PaulZC/F9P_RAWX_Logger/img/RingBuffer.JPG

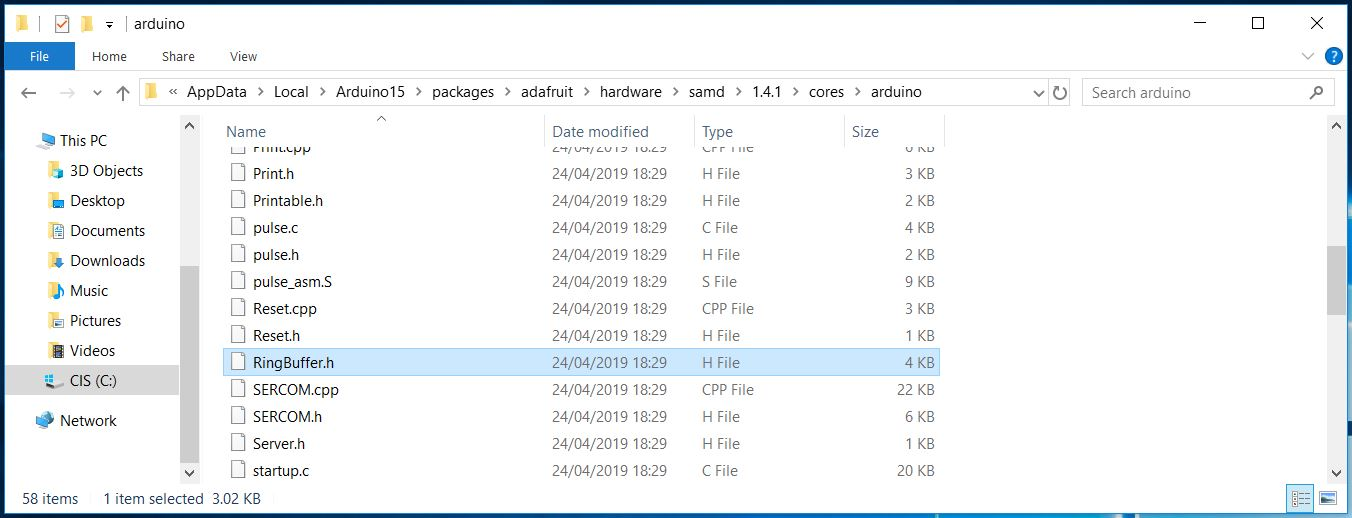
img/RingBuffer.JPG
