PaulZC/F9P_RAWX_Logger/img/VariantCPP.JPG

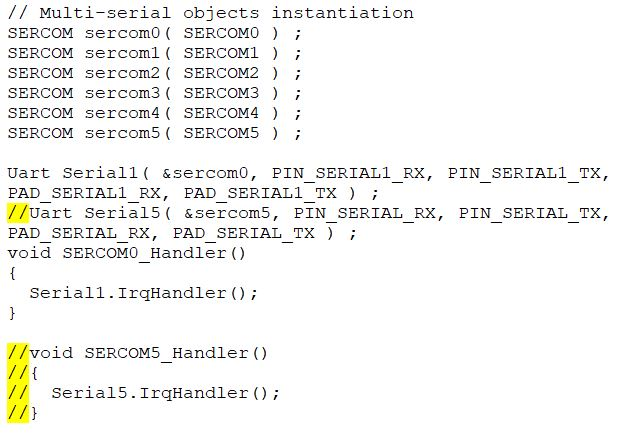
img/VariantCPP.JPG
