PaulZC/F9P_RAWX_Logger/img/VariantH.JPG

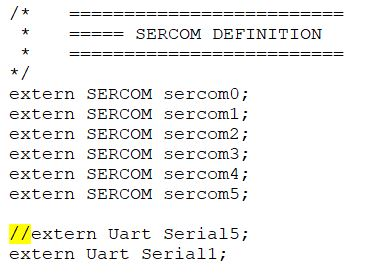
img/VariantH.JPG
