PaulZC/F9P_RAWX_Logger/(threads)

Thread 1 (2019-09-17):

10hz logging

Stefal, 2019-09-17:
Hi!

Thank you for your sketch and the extensive documentation, it' a lot of work.

I've made some modifications on this [branch](https://github.com/Stefal/F9P_RAWX_Logger/tree/datetime_i2c):
- Use i2c to get date and time from the F9P
- Rewrite of the alarm calculation to support more than 60 minutes interval
- nmea output isn't needed anymore and I removed the GPS Adafruit dependencie
- Added a button to start a delayed stop

Do you want a pull request ?

My next goal is to log at [10Hz](https://github.com/Stefal/F9P_RAWX_Logger/tree/high_speed/Arduino) but I have some problems:
- some checksum errors
- Many errors reported when I convert the ubx file to rinex files.
- Sometimes the ringbuffer (24K) is full.

I don't know if my sketch is incorrect, or if I'm hardware limited on UART and if we should use I2c to get the data from the F9P.
Do you have an idea about this?

PaulZC, 2019-09-18:
Hi Stefal,
Apologies - the code in this repo isn't as up to date as it should be. You can find the latest version in the [ZED-F9P_FeatherWing_USB repo](https://github.com/PaulZC/ZED-F9P_FeatherWing_USB). The I2C logger code uses the new multiSetVal functions for the F9 in the SparkFun u-blox library. Please check if [this version](https://github.com/PaulZC/ZED-F9P_FeatherWing_USB/blob/master/Arduino/RAWX_Logger_F9P_I2C/RAWX_Logger_F9P_I2C.ino) meets your needs.
My plan is to update the code in this repo as soon as I have time. I'll close this issue once I've done that. (I'm away from home at the moment.)
Best wishes,
Paul

PaulZC, 2019-11-24:
Hi Stefal,
Thanks again for your comments.
I finally found time to update the RAWX_Logger_F9P_I2C code so it matches the code in the ZED-F9P_FeatherWing_USB repo.
I have also updated RAWX_Logger_F9P so it uses the SparkFun Ublox library and have removed the dependence on the Adafruit library.
I wouldn't recommend logging RAWX data to a single file for longer than 60 minutes. If you have a power glitch while logging, you could lose all your data. Joining the .ubx files together is easy to do so I'd recommend doing that if you can.
The delayed stop is a nice feature but I won't be adding it as I'd like to maintain compatibility with the [RAWX_Logger_Switches](https://github.com/PaulZC/RAWX_Logger_Switches).
I hope the I2C code fixes your 10Hz logging issues. Please let me know if it does.
All the best,
Paul

Stefal, 2020-09-18:
Hi, and thank you for the update!
I'm still stuck at 8Hz. It looks like an arduino sd card bandwidth limit.

Sorry for answering so late, I'm a little busy on other projects, perhaps this one could interesting you: [RTKBase](https://github.com/Stefal/rtkbase)

PaulZC, 2020-09-18:
Hi @Stefal ,
It may not be an SD card issue. It is probably because you have too many constellations enabled?
I have had RAWX running at 20Hz, but you can only do this using GPS only. If I have all constellations enabled, I2C starts to fail at about 5Hz. Sometimes you can go faster, but it depends how many SV's are in view and so how much RAWX data is being produced.
Good luck with your project! RTKBase looks nice! ;-)
Best wishes,
Paul

Closed 2019-11-24.

Thread 4 (2020-10-06):

SD Card Init Failed

uweboerst, 2020-10-06:
Hi Paul,
I followed your instructions to build a F9P_RAWX_Logger to the letter, but unfortunately I cannot get the adalogger to work properly. I always get the following error message in the serial plotter:

RAWX Logger F9P
Log GNSS RAWX data to SD Card
Green LED = Initial GNSS Fix
Red LED Flash = SD Write
Continuous Red indicates a problem or that logging has been stopped
Initializing GNSS...
Ublox GNSS found!
Rover mode selected
GNSS initialized!
Initializing SD card...
Panic!! SD Card Init Failed, or not present!
Waiting for reset...

I have built the logger twice (as I need a rover and a base station) and both have the same issue. I used different sd cards and formatted them properly but it didn't help.
Do you have any idea what could be the reason?
I would very much appreciate your support as my programing skills are very limited.

Uwe

PaulZC, 2020-10-07:
Hi Uwe ( @uweboerst ),

What size SD card are you using - and have they been formatted with FAT32? Larger SD cards are formatted with ExFAT and the SdFat library does not currently support those. There are some instructions in [paragraph 4 here](https://github.com/PaulZC/F9P_RAWX_Logger/blob/master/HARDWARE.md#adafruit-feather-m0-adalogger).

If you want to test the Adalogger and card, Adafruit have some [examples](https://learn.adafruit.com/adafruit-feather-m0-adalogger/using-the-sd-card) to help you do that.

Please let me know if you need more help!

Best wishes,

Paul

uweboerst, 2020-10-07:
Hi Paul,

thank you for your quick response.

I'm using a SDHC class 10 4GB SD card.

I tested the Adalogger and card with the examples provided by Arduino as suggested and they all work fine.

For example if I run CardInfo I get the following message:

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

But I cannot run any of the examples that come with Bill Greiman's SdFat.

If I run bench§ (see code at the bottom of this post) provided by Greiman I do receive the following message:

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

Is it possible that something is wrong with SdFat by Greiman? Do I have to change a pin or anything else?
Regards
Uwe

Code for bench§ by Bill Greiman:

`/*
 * This program is a simple binary write/read benchmark.
 */
#include <SPI.h>
#include "SdFat.h"
#include "sdios.h"
#include "FreeStack.h"

// Set USE_SDIO to zero for SPI card access.
#define USE_SDIO 0

// SD chip select pin
const uint8_t chipSelect = 4;

// Size of read/write.
const size_t BUF_SIZE = 512;

// File size in MB where MB = 1,000,000 bytes.
const uint32_t FILE_SIZE_MB = 5;

// Write pass count.
const uint8_t WRITE_COUNT = 2;

// Read pass count.
const uint8_t READ_COUNT = 2;
//==============================================================================
// End of configuration constants.
//------------------------------------------------------------------------------
// File size in bytes.
const uint32_t FILE_SIZE = 1000000UL*FILE_SIZE_MB;

uint8_t buf[BUF_SIZE];

// file system
#if USE_SDIO
// Traditional DMA version.
// SdFatSdio sd;
// Faster version.
SdFatSdioEX sd;
#else  // USE_SDIO
SdFat sd;
#endif  // USE_SDIO

// Set ENABLE_EXTENDED_TRANSFER_CLASS to use extended SD I/O.
// Requires dedicated use of the SPI bus.
// SdFatEX sd;

// Set ENABLE_SOFTWARE_SPI_CLASS to use software SPI.
// Args are misoPin, mosiPin, sckPin.
// SdFatSoftSpi<6, 7, 5> sd;

// test file
SdFile file;

// Serial output stream
ArduinoOutStream cout(Serial);
//------------------------------------------------------------------------------
// Store error strings in flash to save RAM.
#define error(s) sd.errorHalt(F(s))
//------------------------------------------------------------------------------
void cidDmp() {
  cid_t cid;
  if (!sd.card()->readCID(&cid)) {
    error("readCID failed");
  }
  cout << F("\nManufacturer ID: ");
  cout << hex << int(cid.mid) << dec << endl;
  cout << F("OEM ID: ") << cid.oid[0] << cid.oid[1] << endl;
  cout << F("Product: ");
  for (uint8_t i = 0; i < 5; i++) {
    cout << cid.pnm[i];
  }
  cout << F("\nVersion: ");
  cout << int(cid.prv_n) << '.' << int(cid.prv_m) << endl;
  cout << F("Serial number: ") << hex << cid.psn << dec << endl;
  cout << F("Manufacturing date: ");
  cout << int(cid.mdt_month) << '/';
  cout << (2000 + cid.mdt_year_low + 10 * cid.mdt_year_high) << endl;
  cout << endl;
}
//------------------------------------------------------------------------------
void setup() {
  Serial.begin(9600);

  // Wait for USB Serial
  while (!Serial) {
    SysCall::yield();
  }
  delay(1000);
  cout << F("\nUse a freshly formatted SD for best performance.\n");

  // use uppercase in hex and use 0X base prefix
  cout << uppercase << showbase << endl;
}
//------------------------------------------------------------------------------
void loop() {
  float s;
  uint32_t t;
  uint32_t maxLatency;
  uint32_t minLatency;
  uint32_t totalLatency;

  // Discard any input.
  do {
    delay(10);
  } while (Serial.available() && Serial.read() >= 0);

  // F( stores strings in flash to save RAM
  cout << F("Type any character to start\n");
  while (!Serial.available()) {
    SysCall::yield();
  }
  cout << F("chipSelect: ") << int(chipSelect) << endl;
  cout << F("FreeStack: ") << FreeStack() << endl;

#if USE_SDIO
  if (!sd.begin()) {
    sd.initErrorHalt();
  }
#else  // USE_SDIO
  // Initialize at the highest speed supported by the board that is
  // not over 50 MHz. Try a lower speed if SPI errors occur.
  if (!sd.begin(chipSelect, SD_SCK_MHZ(50))) {
    sd.initErrorHalt();
  }
#endif  // USE_SDIO
  cout << F("Type is FAT") << int(sd.vol()->fatType()) << endl;
  cout << F("Card size: ") << sd.card()->cardSize()*512E-9;
  cout << F(" GB (GB = 1E9 bytes)") << endl;

  cidDmp();

  // open or create file - truncate existing file.
  if (!file.open("bench.dat", O_RDWR | O_CREAT | O_TRUNC)) {
    error("open failed");
  }

  // fill buf with known data
  for (size_t i = 0; i < (BUF_SIZE-2); i++) {
    buf[i] = 'A' + (i % 26);
  }
  buf[BUF_SIZE-2] = '\r';
  buf[BUF_SIZE-1] = '\n';

  cout << F("File size ") << FILE_SIZE_MB << F(" MB\n");
  cout << F("Buffer size ") << BUF_SIZE << F(" bytes\n");
  cout << F("Starting write test, please wait.") << endl << endl;

  // do write test
  uint32_t n = FILE_SIZE/sizeof(buf);
  cout <<F("write speed and latency") << endl;
  cout << F("speed,max,min,avg") << endl;
  cout << F("KB/Sec,usec,usec,usec") << endl;
  for (uint8_t nTest = 0; nTest < WRITE_COUNT; nTest++) {
    file.truncate(0);
    maxLatency = 0;
    minLatency = 9999999;
    totalLatency = 0;
    t = millis();
    for (uint32_t i = 0; i < n; i++) {
      uint32_t m = micros();
      if (file.write(buf, sizeof(buf)) != sizeof(buf)) {
        sd.errorPrint("write failed");
        file.close();
        return;
      }
      m = micros() - m;
      if (maxLatency < m) {
        maxLatency = m;
      }
      if (minLatency > m) {
        minLatency = m;
      }
      totalLatency += m;
    }
    file.sync();
    t = millis() - t;
    s = file.fileSize();
    cout << s/t <<',' << maxLatency << ',' << minLatency;
    cout << ',' << totalLatency/n << endl;
  }
  cout << endl << F("Starting read test, please wait.") << endl;
  cout << endl <<F("read speed and latency") << endl;
  cout << F("speed,max,min,avg") << endl;
  cout << F("KB/Sec,usec,usec,usec") << endl;

  // do read test
  for (uint8_t nTest = 0; nTest < READ_COUNT; nTest++) {
    file.rewind();
    maxLatency = 0;
    minLatency = 9999999;
    totalLatency = 0;
    t = millis();
    for (uint32_t i = 0; i < n; i++) {
      buf[BUF_SIZE-1] = 0;
      uint32_t m = micros();
      int32_t nr = file.read(buf, sizeof(buf));
      if (nr != sizeof(buf)) {
        sd.errorPrint("read failed");
        file.close();
        return;
      }
      m = micros() - m;
      if (maxLatency < m) {
        maxLatency = m;
      }
      if (minLatency > m) {
        minLatency = m;
      }
      totalLatency += m;
      if (buf[BUF_SIZE-1] != '\n') {
        error("data check");
      }
    }
    s = file.fileSize();
    t = millis() - t;
    cout << s/t <<',' << maxLatency << ',' << minLatency;
    cout << ',' << totalLatency/n << endl;
  }
  cout << endl << F("Done") << endl;
  file.close();
}`

PaulZC, 2020-10-07:
Hi Uwe,

This is really very strange... I have lots of Adaloggers and I have never seen this issue before.

If both of your Adaloggers behave the same, it is unlikely to be a hardware fault.

I wonder if something has changed in one of the libraries or maybe the Adafruit SAMD board package? Maybe you could try using an earlier version of the Adafruit SAMD boards to being with. You can install this through the boards manager.

Let me know if you still have problems and I will try and replicate it here.

Best wishes,

Paul

johnhulth, 2021-01-14:
Hi Paul, I was going to try your RAWX logger but i run into the same problem as Uwe. The Arduino Cardifo works fine, but i have problem with the SDfat library. I have tried both the original and Adafruits fork of SDfat with no luck. Did you find out what the problem might be?

/John

johnhulth, 2021-01-14:
```
RAWX Logger F9P
Log GNSS RAWX data to SD card
Green LED = Initial GNSS Fix
Red LED Flash = SD Write
Continuous Red indicates a problem or that logging has been stopped
Initializing GNSS...
Panic!! Ublox GNSS not detected at default I2C address. Please check wiring. Freezing!
```
-------------------------------------------------------------
```
Initializing SD card...Wiring is correct and a card is present.

Card type:         SDHC
Clusters:          486880
Blocks x Cluster:  64
Total Blocks:      31160320

Volume type is:    FAT32
Volume size (Kb):  15580160
Volume size (Mb):  15215
Volume size (Gb):  14.86

Files found on the card (name, date and size in bytes):
SYSTEM~1/     2021-01-14 11:44:48
  WPSETT~1.DAT  2021-01-14 11:44:48 12
  INDEXE~1      2021-01-14 11:44:52 76
DATALOG.TXT   2000-01-01 01:00:00 24492
TEST.TXT      2021-01-14 11:59:24 0
```

johnhulth, 2021-01-14:
```
RAWX Logger F9P
Log GNSS RAWX data to SD card
Green LED = Initial GNSS Fix
Red LED Flash = SD Write
Continuous Red indicates a problem or that logging has been stopped
Initializing GNSS...
Ublox GNSS found!
ROVER mode selected
GNSS initialized!
Initializing SD card...
Panic!! SD Card Init failed, or not present!
Waiting for reset...
```
```
Initializing SD card...Wiring is correct and a card is present.

Card type:         SDHC
Clusters:          486880
Blocks x Cluster:  64
Total Blocks:      31160320

Volume type is:    FAT32
Volume size (Kb):  15580160
Volume size (Mb):  15215
Volume size (Gb):  14.86

Files found on the card (name, date and size in bytes):
SYSTEM~1/     2021-01-14 11:44:48
  WPSETT~1.DAT  2021-01-14 11:44:48 12
  INDEXE~1      2021-01-14 11:44:52 76
DATALOG.TXT   2000-01-01 01:00:00 24492
TEST.TXT      2021-01-14 11:59:24 0

```

johnhulth, 2021-01-14:
Hi again, I found the problem.

https://github.com/PaulZC/F9P_RAWX_Logger/blob/fd0369ff45fa35357e6a470c0e77387afde262a0/Arduino/RAWX_Logger_F9P_I2C/RAWX_Logger_F9P_I2C.ino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

I had to lower the SPI speed to 12MHz
`if (!sd.begin(cardSelect, SD_SCK_MHZ(12))) {`
then it worked fine. Could be that i have a low quality SD-card. Obviously, it could not handle 50MHz.

```
RAWX Logger F9P
Log GNSS RAWX data to SD card
Green LED = Initial GNSS Fix
Red LED Flash = SD Write
Continuous Red indicates a problem or that logging has been stopped
Initializing GNSS...
Ublox GNSS found!
ROVER mode selected
GNSS initialized!
Initializing SD card...
SD Card initialized!
Waiting for GNSS fix...

Time: 14:20:34.0
Date: 14/1/2021
Fix: 3
Location: Lat: 59.658035 Lon: 10.631269 (degrees) Alt: 59.44 (m)
Ground Speed (m/s): 0.015
Heading: 0.0
Satellites: 29
PDOP: 1.08
Battery(V): 4.29
```

PaulZC, 2021-01-14:
Great detective work @johnhulth - thank you for finding the problem!

@uweboerst : does John's solution work for you?

You might both be interested in the new version of the SparkFun u-blox GNSS library - it now has data logging functions built-in.
The new repo is [here](https://github.com/sparkfun/SparkFun_u-blox_GNSS_Arduino_Library) and the new data logging examples are [here](https://github.com/sparkfun/SparkFun_u-blox_GNSS_Arduino_Library/tree/master/examples/Data_Logging). The examples use the original Arduino SD library, which is quite slow. You will get better results with SdFat - please see [this issue](https://github.com/sparkfun/SparkFun_u-blox_GNSS_Arduino_Library/issues/1) for more details.

The new GNSS library has not yet been added to the Arduino Library Manager, but that will happen soon (probably in one or two days).

Best wishes,

Paul

johnhulth, 2021-01-14:
Thanks Paul to point us to the new version of the u-blox library!

One thing I was wondering about, is there a reason why you power the F9P with 5V instead of with the 3.3V from the feather?

Also, I was running the RAWX logger with SPI speed 12Mhz, but already after a few minutes the feather hangs. Using the SDfat Adafruit fork and power from 3.3V. Haven't had time to investigate this, but any thoughts are welcome. Here is the last debug output:
```
Sending: CLS:NAV ID:PVT Len: 0x0 Payload:
sendCommand: Waiting for No ACK response
checkUbloxI2C: OK, zero bytes available
checkUbloxI2C: OK, zero bytes available
checkUbloxI2C: OK, zero bytes available
checkUbloxI2C: OK, zero bytes available
checkUbloxI2C: OK, zero bytes available
checkUbloxI2C: OK, zero bytes available
checkUbloxI2C: OK, zero bytes available
checkUbloxI2C: OK, zero bytes available
checkUbloxI2C: OK, zero bytes available
checkUbloxI2C: OK, zero bytes available
checkUbloxI2C: Reading 100 bytes
Incoming: Size: 92 Received: CLS:NAV ID:PVT Len: 0x5C Payload: A8 2E B1 18 E5 7 1 E 13 4 7 37 18 0 0 0 28 D7 F8 FF 3 1 EA 19 53 34 56 6 37 18 8F 23 B4 E0 0 0 74 48 0 0 E7 3 0 0 58 6 0 0 9 0 0 0 EB FF FF FF DF FF FF FF 17 0 0 0 0 0 0 0 E4 0 0 0 80 A8 12 1 6E 0 0 0 6C 18 42 3E 0 0 0 0 0 0 0 0
packetCfg now valid
packetCfg classAndIDmatch
waitForNoACKResponse: valid data with CLS/ID match after 1017 msec
Location: Lat: 59.658043 Lon: 10.631278 (degrees) Alt: 57.52 (m)
Ground Speed (m/s): 0.023
Heading: 0.0
Satellites: 25
PDOP: 1.10
Battery(V): 4.31
getPVT: Polling

Sending: CLS:NAV ID:PVT Len: 0x0 Payload:
sendCommand: Waiting for No ACK response
checkUbloxI2C: OK, zero bytes available
checkUbloxI2C: OK, zero bytes available
checkUbloxI2C: OK, zero bytes available
checkUbloxI2C: OK, zero bytes available
checkUbloxI2C: OK, zero bytes available
checkUbloxI2C: OK, zero bytes available
checkUbloxI2C: OK, zero bytes available
checkUbloxI2C: OK, zero bytes available
checkUbloxI2C: OK, zero bytes available
checkUbloxI2C: OK, zero bytes available
checkUbloxI2C: Reading 100 bytes
Incoming: Size: 92 Received: CLS:NAV ID:PVT Len: 0x5C Payload: 90 32 B1 18 E5 7 1 E 13 4 8 37 18 0 0 0 F6 D5 F8 FF 3 1 EA 19 52 34 56 6 37 18 8F 23 D2 E0 0 0 92 48 0 0 E8 3 0 0 5B 6 0 0 0 0 0 0 FB FF FF FF F2 FF FF FF 5 0 0 0 0 0 0 0 EB 0 0 0 80 A8 12 1 6E 0 0 0 6C 18 42 3E 0 0 0 0 0 0 0 0
packetCfg now valid
packetCfg classAndIDmatch
waitForNoACKResponse: valid data with CLS/ID match after 1016 msec
getPVT: Polling

Sending: CLS:NAV ID:PVT Len: 0x0 Payload:
sendCommand: Waiting for No ACK response
checkUbloxI2C: OK, zero bytes available
checkUbloxI2C: OK, zero bytes available
checkUbloxI2C: OK, zero bytes available
checkUbloxI2C: OK, zero bytes available
checkUbloxI2C: OK, zero bytes available
checkUbloxI2C: OK, zero bytes available
checkUbloxI2C: OK, zero bytes available
checkUbloxI2C: OK, zero bytes available
checkUbloxI2C: OK, zero bytes available
checkUbloxI2C: Reading 100 bytes
Incoming: Size: 92 Received: CLS:NAV ID:PVT Len: 0x5C Payload: 78 36 B1 18 E5 7 1 E 13 4 9 37 18 0 0 0 C4 D4 F8 FF 3 1 EA 19 51 34 56 6 37 18 8F 23 F2 E0 0 0 B2 48 0 0 EA 3 0 0 5F 6 0 0 2 0 0 0 FF FF FF FF E0 FF FF FF 2 0 0 0 0 0 0 0 F4 0 0 0 80 A8 12 1 6E 0 0 0 6C 18 42 3E 0 0 0 0 0 0 0 0
packetCfg now valid
packetCfg classAndIDmatch
waitForNoACKResponse: valid data with CLS/ID match after 915 msec

Sending: CLS:CFG ID:0x8A Len: 0xA Payload: 0 1 0 0 1 0 21 30 FA 0
sendCommand: Waiting for ACK response
checkUbloxI2C: OK, zero bytes available
checkUbloxI2C: Reading 10 bytes
Incoming: Size: 2 Received: CLS:ACK ID:0x1 Len: 0x2 Payload: 6 8A
packetCfg now valid
packetAck now valid
packetCfg classAndIDmatch
packetAck classAndIDmatch
waitForACKResponse: no data and valid ACK after 102 msec

Sending: CLS:CFG ID:0x8A Len: 0x31 Payload: 0 1 0 0 A5 2 91 20 1 32 2 91 20 1 79 1 91 20 1 2A 0 91 20 0 7 0 91 20 1 1B 0 91 20 1 31 0 93 20 3 6 0 93 10 1 BB 0 91 20 1
sendCommand: Waiting for ACK response
checkUbloxI2C: OK, zero bytes available
checkUbloxI2C: Reading 10 bytes
Incoming: Size: 2 Received: CLS:ACK ID:0x1 Len: 0x2 Payload: 6 8A
packetCfg now valid
packetAck now valid
packetCfg classAndIDmatch
packetAck classAndIDmatch
waitForACKResponse: no data and valid ACK after 103 msec
Logging to 20210114/r_190409.ubx

```

PaulZC, 2021-01-14:
The ZED draws quite a lot of current - over 100mA - so it is kinder to use 5V instead of asking the Adalogger regulator to provide all that current.
It also lets you power the system from the USB connector on the ZED breakout, if you want to.

PaulZC, 2021-05-31:
Closing - because I think this issue is stale...
Please re-open if you need more advice.
Best wishes,
Paul

Closed 2021-05-31.

Thread 6 (2021-05-31):

Using UAR2 On Ardusimple F9P board

csomyy, 2021-05-31:
Dear Paul

Thank you for your fantastic code,
Could you please discribe me, how to flip the code to be used on the UART2 port of the Ardusimple receiver?
I need the UART1 for my drone.

PaulZC, 2021-05-31:
Hi @csomyy ,

This is quite old code now, and out of date in many ways. The main thing to do will be to change all of the ValSet keys to use UART2 instead of UART1:

https://github.com/PaulZC/F9P_RAWX_Logger/blob/fd0369ff45fa35357e6a470c0e77387afde262a0/Arduino/RAWX_Logger_F9P_I2C/RAWX_Logger_F9P_I2C.ino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

If you upgrade to the new [SparkFun u-blox library (v2)](https://github.com/sparkfun/SparkFun_u-blox_GNSS_Arduino_Library#v20), the keys are defined for you e.g.:

https://github.com/sparkfun/SparkFun_u-blox_GNSS_Arduino_Library/blob/929a9ee6a27a34b653a1c42031cba66d395b1598/src/u-blox_config_keys.h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

Best wishes,
Paul

Closed 2021-05-31.

Thread 7 (2021-08-04):

Restarting raw log

csomyy, 2021-08-04:
Hi Paul

Finally i could make this logger code work with ardufeather M0 board.
I'm using i2c code and 230400 baud with an Ardusimple F9P2B V3 board.
My issue is right now that logging restarts after a few minutes. Like 2-3. With the standard 15min rotation and 60min rotation setting too.
I had to reduce the sdcard frequency to 12mHz to work.
I tried to paste a pic ..

Do you have any suggestions where to look with this problem?

Earlier you mentioned a fresh code. Is there any other out of the box logging software for this M0 board?

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

csomyy, 2021-08-04:
Ok, right now i found a case that log restarts if ubx_nmea_state == sync_lost.

Why is this necessary?

PaulZC, 2021-08-04:
Hi @csomyy ,
It looks like you are trying to log RAWX data at 10Hz?
The code may not be able to keep up with that data rate.
Please try 5Hz and see what happens.
If the code loses sync (sync_lost) it will start looking for a new UBX packet starting with 0xB5. This will happen if data is lost or if there is a checksum error.
Best wishes,
Paul

PaulZC, 2022-10-01:
Hi @csomyy ,

I am going to archive this repository. The logging code is out of date and has been superseded by the [SparkFun u-blox GNSS library data logging examples](https://github.com/sparkfun/SparkFun_u-blox_GNSS_Arduino_Library/tree/main/examples/Data_Logging).

Best wishes,
Paul

Closed 2022-10-01.
