PaulZC/F9P_RAWX_Logger/(commit log)

2019-05-27 Corrected the code inserts
2019-05-29 Corrected the key IDs for little endian
    [RAWX_Logger_F9P.ino]
2019-05-29 Tested - no longer work in progress!
    [RAWX_Logger_F9P.ino]
